MSTRocketDesignTeam/SRAD-Flight-Computer/hardware/pinMapping.pdf

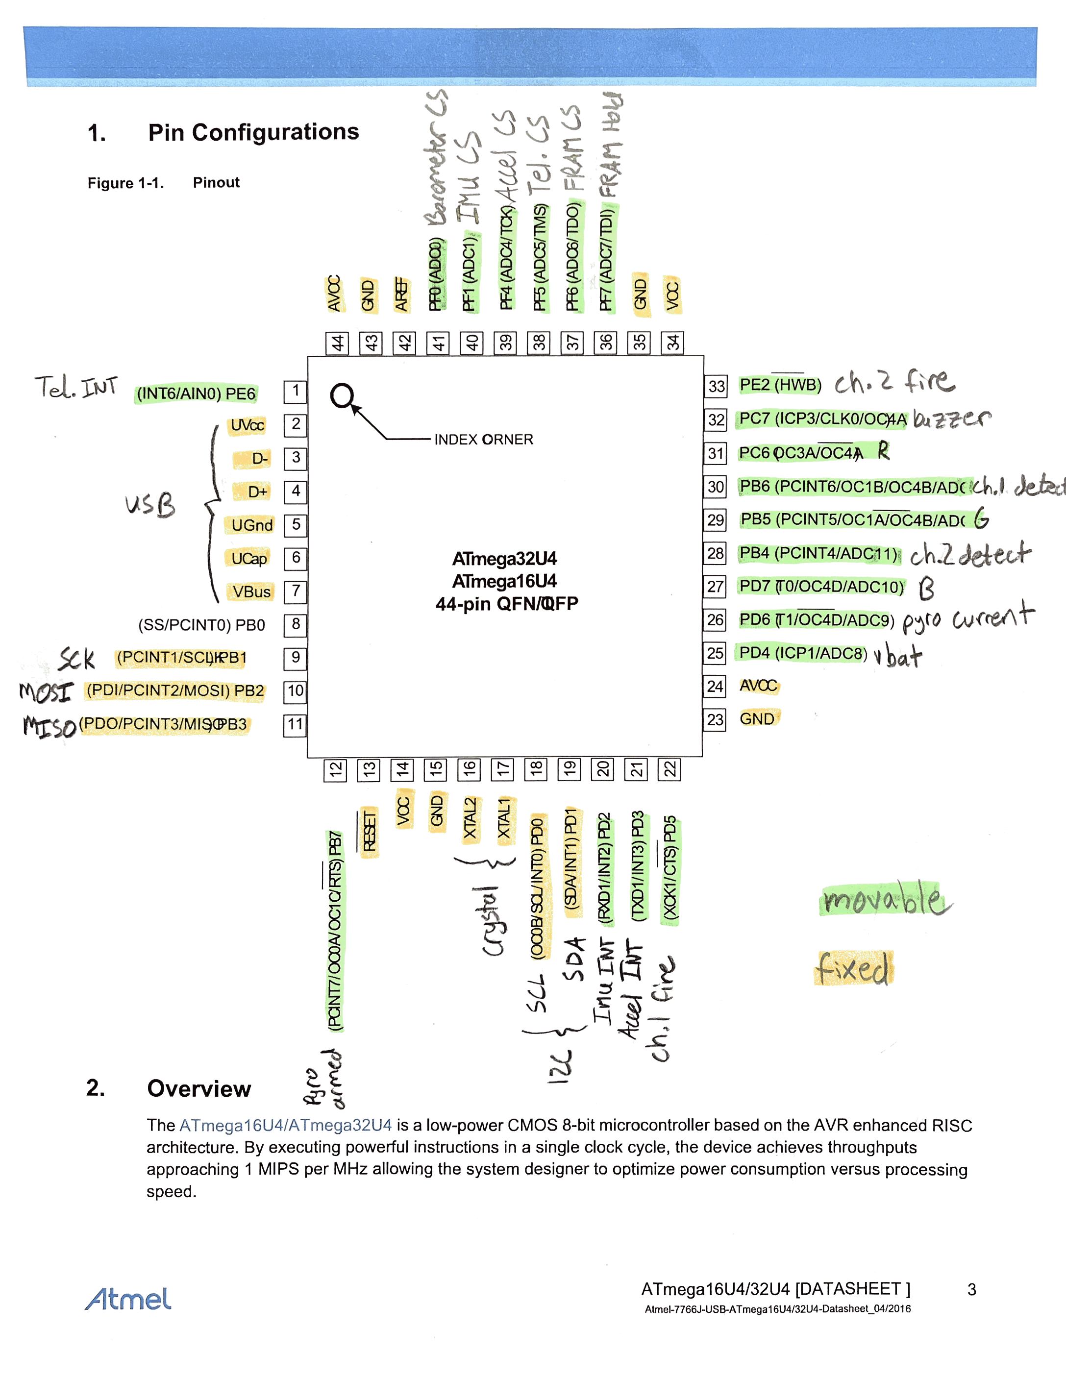
[picture p2: page 1]
