MSTRocketDesignTeam/SRAD-Flight-Computer/firmware/fram-testing/platformio-arduino-framRead/basicV2CodeOverview.png

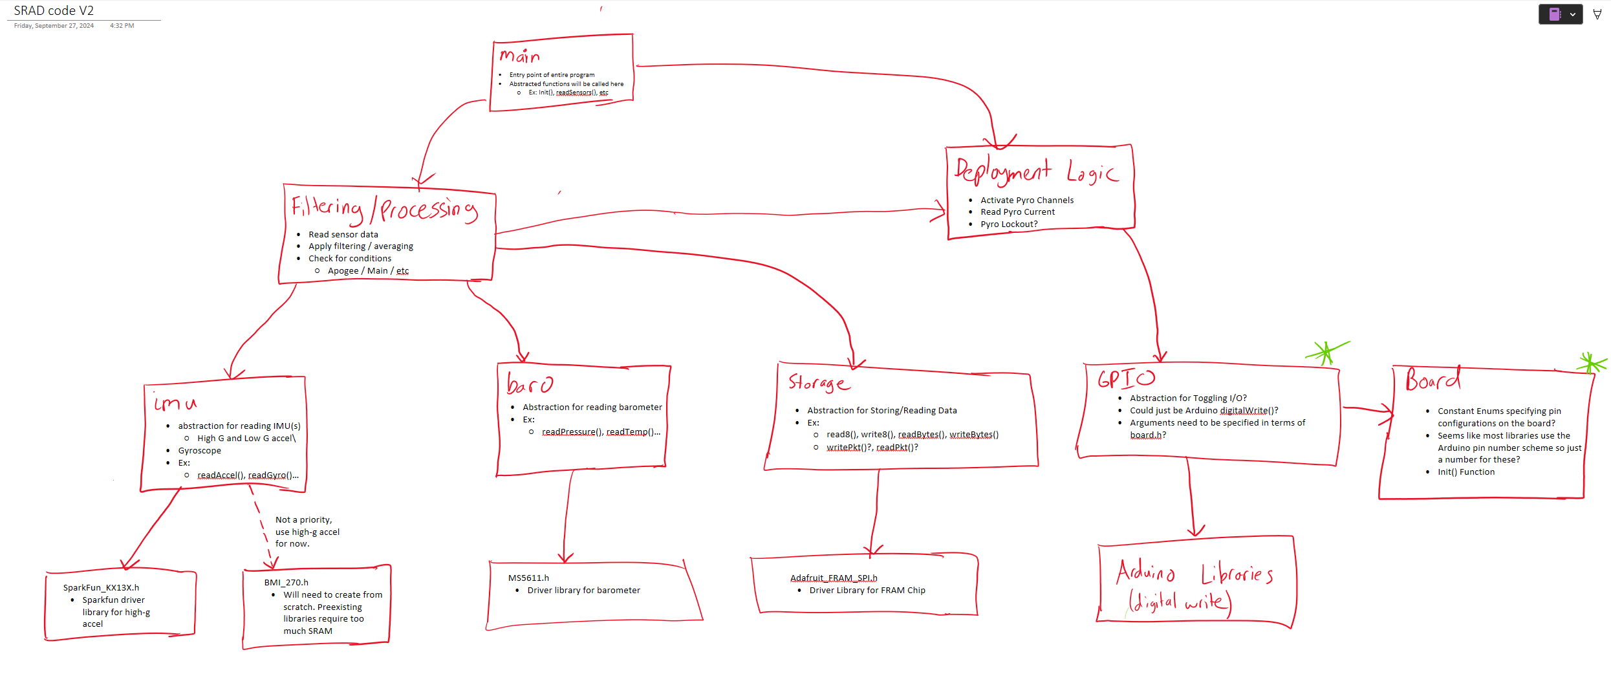
firmware/fram-testing/platformio-arduino-framRead/basicV2CodeOverview.png
