MSTRocketDesignTeam/SRAD-Flight-Computer/hardware/kicad/assets/fram_WP.png

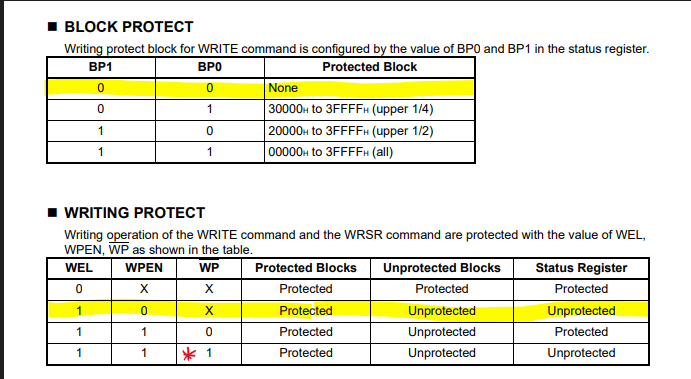
hardware/kicad/assets/fram_WP.png
