MSTRocketDesignTeam/SRAD-Flight-Computer/hardware/kicad/shipping.png

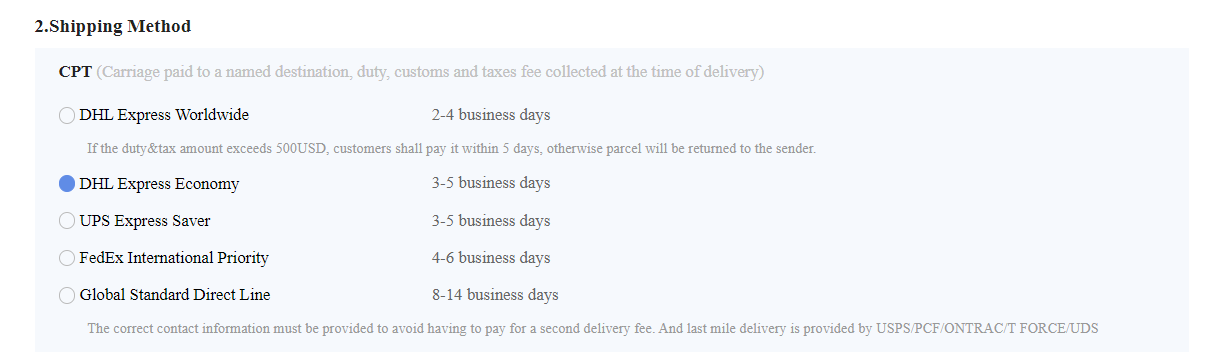
hardware/kicad/shipping.png
