MSTRocketDesignTeam/SRAD-Flight-Computer/hardware/kicad/footprints/BMI270/BMI270.step

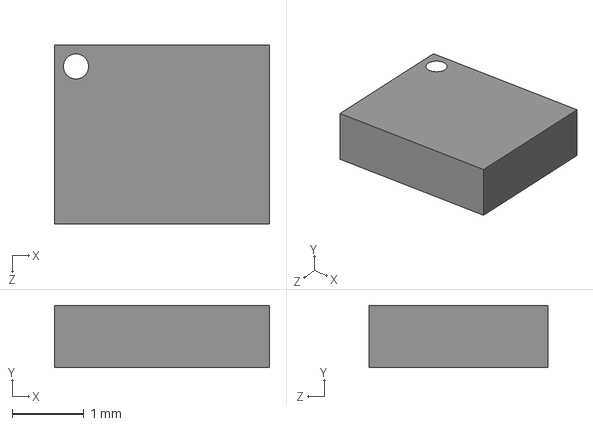
[picture p6: CAD file, 2023-09-16]
hardware/kicad/footprints/BMI270/BMI270.step
3.00 x 0.87 x 2.50 mm
