MSTRocketDesignTeam/SRAD-Flight-Computer/hardware/kicad/footprints/CONSMA020.062/CONSMA020.062-G.step

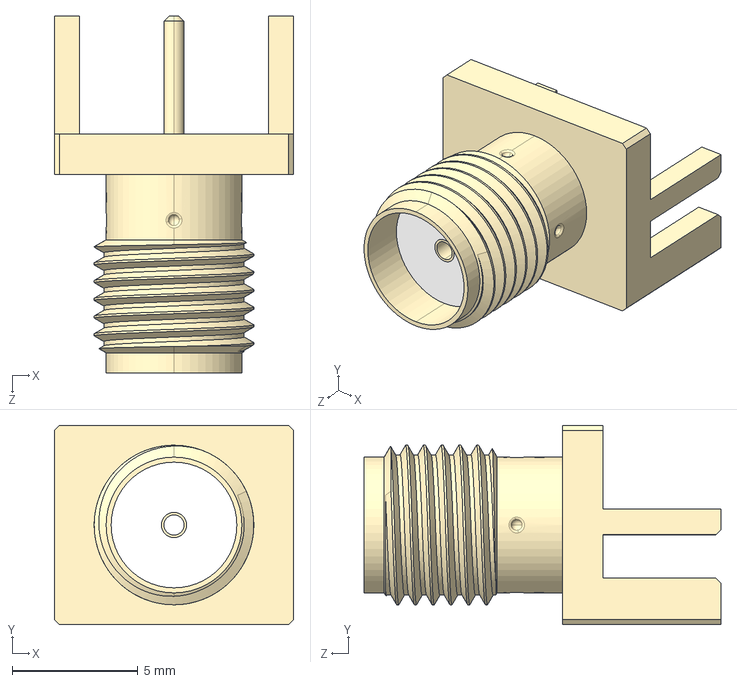
[picture p7: CAD file, 2022-08-10]
hardware/kicad/footprints/CONSMA020.062/CONSMA020.062-G.step
9.52 x 7.92 x 14.2 mm
