MSTRocketDesignTeam/SRAD-Flight-Computer/hardware/kicad/footprints/282834-2/282834-2.step

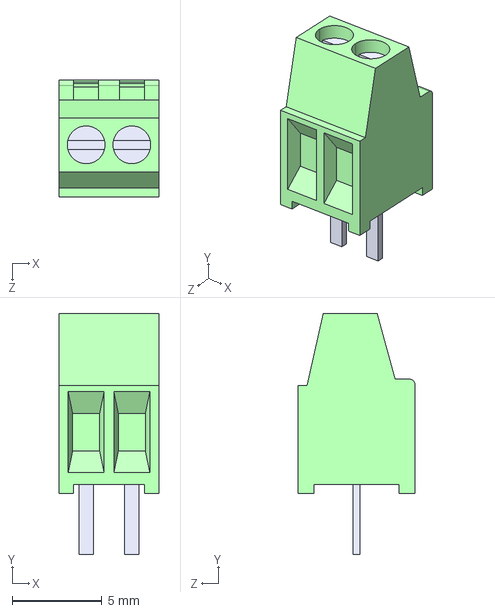
[picture p8: CAD file, 2023-10-20]
hardware/kicad/footprints/282834-2/282834-2.step
5.54 x 13.4 x 6.50 mm
