MSTRocketDesignTeam/SRAD-Flight-Computer/hardware/kicad/footprints/282834-4/282834-4.STEP

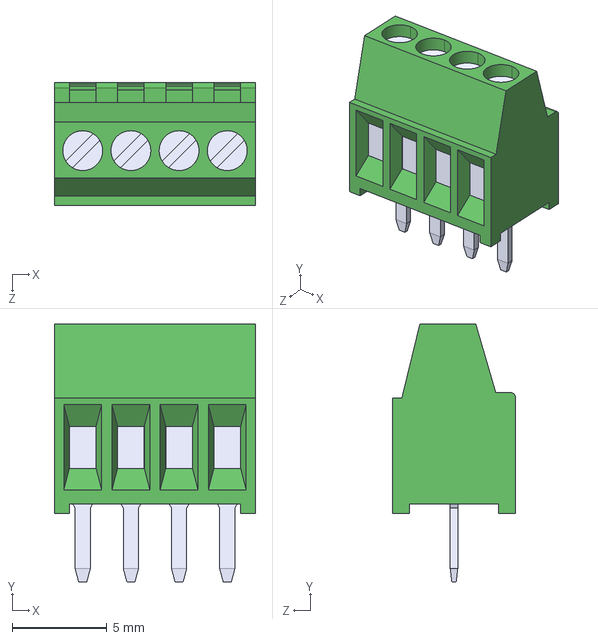
[picture p9: CAD file, 2023-09-16]
hardware/kicad/footprints/282834-4/282834-4.STEP
10.6 x 13.6 x 6.50 mm
