MSTRocketDesignTeam/SRAD-Flight-Computer/firmware/fram-testing/platformio-arduino-framRead/ReadME.md

# Bootloader
Caterina.zip contains a modified bootloader that disables the USB VREG and disables pin output.
