MSTRocketDesignTeam/SRAD-Flight-Computer/firmware/altimeter-data-dump/actualExportTestCSVPressure.csv

Time (s) | Pressure (MilliBar)
0.026 | 959.91
0.052 | 959.92
0.077 | 959.91
0.104 | 959.94
0.129 | 959.89
0.155 | 959.93
0.181 | 959.86
0.206 | 959.9
0.233 | 959.87
0.259 | 959.85
0.284 | 958.48
0.31 | 959.91
0.335 | 959.5099
0.362 | 959.38
0.388 | 959.2
0.439 | 958.93
0.464 | 958.56
0.49 | 957.48
0.517 | 956.78
0.542 | 955.94
0.568 | 954.79
0.593 | 953.77
0.62 | 952.53
0.646 | 951.37
0.671 | 950.58
0.697 | 950.03
0.722 | 949.55
0.749 | 948.87
0.775 | 947.62
0.8 | 946.27
0.851 | 944.89
0.877 | 943.6
0.904 | 940.54
0.929 | 938.88
0.955 | 937.0099
0.98 | 935.31
1.006 | 933.48
1.033 | 931.63
1.058 | 930.03
1.084 | 929.16
1.109 | 931.74
1.135 | 932.31
1.162 | 932.12
1.187 | 931.75
1.213 | 931.3
1.264 | 930.92
1.29 | 930.42
1.316 | 929.41
1.342 | 928.83
1.368 | 928.23
1.393 | 927.66
1.419 | 927.04
1.445 | 926.45
1.471 | 925.97
1.497 | 925.48
1.522 | 924.92
1.549 | 924.41
1.574 | 923.82
1.6 | 923.36
1.626 | 922.82
1.677 | 922.31
1.703 | 921.77
1.729 | 920.75
1.755 | 920.36
1.78 | 919.81
1.806 | 919.24
1.832 | 918.77
1.858 | 918.38
1.884 | 917.8
1.909 | 917.33
1.935 | 916.83
1.961 | 916.37
1.987 | 915.76
2.013 | 915.33
2.038 | 914.83
2.089 | 914.37
2.116 | 913.94
2.142 | 912.91
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
