MSTRocketDesignTeam/SRAD-Flight-Computer/firmware/altimeter-data-dump/actualExportTestCSVAccel.csv

Time (s) | AccelX (g) | AccelY (g) | AccelZ (g)
0.0000 | 63.9980 | 63.9980 | 63.9980
0.0260 | 127.9277 | 126.9863 | 127.8770
0.0520 | 127.9316 | 126.9883 | 127.8535
0.0780 | 127.9414 | 127.0137 | 127.8711
0.1040 | 127.9336 | 126.9883 | 127.9062
0.1290 | 127.9238 | 126.9902 | 127.8965
0.1550 | 127.9277 | 127.0488 | 127.8535
0.1810 | 127.9258 | 127.0332 | 127.8496
0.2070 | 127.9258 | 127.0332 | 127.8809
0.2330 | 127.9199 | 127.0508 | 127.8730
0.2590 | 127.9082 | 126.9941 | 127.8750
0.2840 | 127.5586 | 116.9941 | 124.7461
0.3100 | 125.8672 | 105.3730 | 126.4688
0.3360 | 127.3770 | 101.2500 | 5.6699
0.3620 | 0.2676 | 99.2109 | 3.6289
0.3880 | 0.4473 | 98.0254 | 1.7109
0.4130 | 63.9980 | 63.9980 | 63.9980
0.4390 | 2.3477 | 97.0977 | 1.8496
0.4640 | 1.8340 | 95.4824 | 0.8945
0.4910 | 0.1250 | 94.7246 | 0.0879
0.5170 | 0.2500 | 94.0430 | 0.6465
0.5420 | 0.2656 | 93.7207 | 1.0059
0.5680 | 0.1855 | 93.4102 | 1.2227
0.5940 | 127.9863 | 93.0000 | 1.2148
0.6200 | 0.4219 | 92.8164 | 1.4141
0.6460 | 0.1699 | 92.9258 | 1.3926
0.6710 | 127.9785 | 92.7051 | 1.3379
0.6970 | 127.7109 | 92.5078 | 1.0117
0.7230 | 0.1289 | 92.5195 | 0.9375
0.7490 | 0.6133 | 92.6133 | 1.0137
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
