MSTRocketDesignTeam/SRAD-Flight-Computer/(commit log)

2022-08-08 work on preliminary dev board schematic
    [dev-board.kicad_pcb, dev-board.kicad_sch, esp32-s3fn8.kicad_sch, icm-20608g.kicad_sch, kx134-1211.kicad_sch, ms5611.kicad_sch]
2022-08-10 Update Files
    [dev-board.kicad_sch, icm-20608g.kicad_sch, kx134-1211.kicad_sch, mmc5983ma.kicad_sch, ms5611.kicad_sch, zoe-m8q.kicad_sch]
2022-08-10 More RF Stuff Routed
    [dev-board.kicad_sch, zoe-m8q.kicad_sch]
2022-08-12 more gps work
    [dev-board.kicad_sch]
2022-08-13 finished GPSschematic
    [dev-board.kicad_sch, sx1262.kicad_sch, zoe-m8q.kicad_sch]
2022-08-14 file sync
    [dev-board.kicad_sch, mmc5983ma.kicad_sch, zoe-m8q.kicad_sch]
2022-08-17 rf is hard
    [dev-board.kicad_sch, icm-20608g.kicad_sch, kx134-1211.kicad_sch, mmc5983ma.kicad_sch, ms5611.kicad_sch, sx1262.kicad_sch, zoe-m8q.kicad_sch]
2022-09-01 some rf work
    [SX1262MB1PAS_915MHz_e449v01a_BOM.xlsx, dev-board.kicad_sch, sx1262.kicad_sch]
2023-09-15 purging old files
    [SX1262MB1PAS_915MHz_e449v01a_BOM.xlsx, dev-board.kicad_pcb, dev-board.kicad_sch, esp32-s3fn8.kicad_sch, icm-20608g.kicad_sch, kx134-1211.kicad_sch, mmc5983ma.kicad_sch, ms5611.kicad_sch]
2023-09-16 created kicad project and added datasheets
    [FC.kicad_pcb, FC.kicad_sch, SX1262MB1PAS_915MHz_e449v01a_BOM.xlsx]
2023-09-16 added footprints
    [282834-4.STEP, BMI270.step, CONSMA020.062-G.step]
2023-09-16 added pyro channel sheet
    [FC.kicad_sch, pyro_channel.kicad_sch]
2023-09-16 created schematic files
    [FC.kicad_sch, bmi-270.kicad_sch, bmm-350.kicad_sch, kx134-1211.kicad_sch, m10s.kicad_sch, mb85rs2mtapnf.kicad_sch, ms5611.kicad_sch, ra-01sh.kicad_sch]
2023-09-16 created microcontroller schematic
    [FC.kicad_sch, atmega32u4.kicad_sch, bmi-270.kicad_sch, bmm-350.kicad_sch, kx134-1211.kicad_sch, m10s.kicad_sch, mb85rs2mtapnf.kicad_sch, ms5611.kicad_sch]
2023-09-16 assigned schematics
    [FC.kicad_sch]
2023-09-16 added ms5611 t o schematic
    [ms5611.kicad_sch]
2023-09-16 FRAM schematic
    [mb85rs2mtapnf.kicad_sch]
2023-09-18 fixed sma connector, added to .gitignore
2023-09-20 progress on microcontroller USB
    [atmega32u4.kicad_sch]
2023-09-20 added tc2030 header
    [atmega32u4.kicad_sch]
2023-09-21 finalized tc2030 symbol
    [atmega32u4.kicad_sch]
2023-09-22 syncing uC board before fixing files
    [atmega32u4.kicad_sch]
2023-09-22 uC signal routing
    [atmega32u4.kicad_sch, pyro_channel.kicad_sch]
2023-09-22 uC pinMap progress
    [atmega32u4.kicad_sch]
2023-09-22 updated ms5611 schematic
    [ms5611.kicad_sch]
2023-09-22 Storage Updated
    Updated hierarchal sheet and added pins in and out of sheet
    [mb85rs2mtapnf.kicad_sch]
2023-09-22 Storage Updated
    Didn't save. Added pins to hierarchal sheets. In/Out
    [FC.kicad_sch, atmega32u4.kicad_sch, mb85rs2mtapnf.kicad_sch, ms5611.kicad_sch, ra-01sh.kicad_sch]
2023-09-22 Added Resistor
    [bmi-270.kicad_sch]
2023-09-22 Removed debug from pyro schematic
    [pyro_channel.kicad_sch]
2023-09-22 updated barometer schematic
    [ms5611.kicad_sch, ra-01sh.kicad_sch]
2023-09-22 edited barometer
    [ms5611.kicad_sch]
2023-09-22 fixing weird bugs
    [FC.kicad_sch, pyro_channel.kicad_sch, ra-01sh.kicad_sch]
2023-09-22 fixed weird fork on high g accel sheet
    [kx134-1211.kicad_sch]
2023-09-22 added spi and cs pins
    [atmega32u4.kicad_sch]
2023-09-23 progress on uC
    [atmega32u4.kicad_sch]
2023-09-27 added buzzer
    [atmega32u4.kicad_sch]
2023-09-28 added comments to storage and telemetry radio
    [mb85rs2mtapnf.kicad_sch, ra-01sh.kicad_sch]
2023-09-29 massive comment upload
    [atmega32u4.kicad_sch, bmi-270.kicad_sch, bmm-350.kicad_sch, kx134-1211.kicad_sch, m10s.kicad_sch, ms5611.kicad_sch]
2023-09-29 finished comments
    [bmi-270.kicad_sch]
2023-09-29 literally moved half the microcontroller pins :(
    [atmega32u4.kicad_sch, ra-01sh.kicad_sch]
2023-09-29 microcontroller done?
    [atmega32u4.kicad_sch]
2023-09-29 added ground station conversion breakout pads
    [atmega32u4.kicad_sch]
2023-09-29 fixed barometer board haha - ben
    [ms5611.kicad_sch]
2023-09-29 Magnometer and LDO integrated
    Constructed the schematic with LDO for voltage regulation for the BMM350 Magnetometer
    [bmm-350.kicad_sch]
2023-09-29 Updated labels
    [pyro_channel.kicad_sch]
2023-09-29 full pin utilization
    [atmega32u4.kicad_sch]
2023-09-29 fixed schematic RA-01SH
    [ra-01sh.kicad_sch]
2023-09-30 Fixed schematic file
    [bmi-270.kicad_sch]
2023-09-30 Max Working Current
    [ra-01sh.kicad_sch]
2023-09-30 added max current
    [atmega32u4.kicad_sch]
2023-09-30 Current Max
    [ms5611.kicad_sch]
2023-09-30 added invert on cs
    [ra-01sh.kicad_sch]
2023-09-30 Added Schematic stuff
    [bmi-270.kicad_sch]
2023-09-30 made gps
    [m10s.kicad_sch]
2023-09-30 Finnished Schematic?
    [bmi-270.kicad_sch]
2023-09-30 fixed schematic
    [kx134-1211.kicad_sch]
2023-10-01 started linking together FC, changed cs directions
    [FC.kicad_sch, bmi-270.kicad_sch, kx134-1211.kicad_sch, ms5611.kicad_sch]
2023-10-01 linking together schematics
    [FC.kicad_sch]
2023-10-01 changed FRAM labels
    [mb85rs2mtapnf.kicad_sch]
2023-10-01 corrected label on magnetometer
    [FC.kicad_sch, bmm-350.kicad_sch]
2023-10-01 corrected I2c line labels
    [FC.kicad_sch, bmm-350.kicad_sch, m10s.kicad_sch]
2023-10-01 added spi and i2c bus
    [FC.kicad_sch]
2023-10-01 Changed LDO to Fixed LM1117-1.8
    Changed LDO cheaper 1.8V LM1117
    [bmm-350.kicad_sch]
2023-10-01 added imu interrupt
    [FC.kicad_sch, bmi-270.kicad_sch]
2023-10-01 checked gps
    [m10s.kicad_sch]
2023-10-02 work on linking everything together
    [FC.kicad_sch, atmega32u4.kicad_sch]
2023-10-02 Fixed BMM350 capacitors
    Fixed BMM350 Capacitors by connecting to ground and connecting to the power pins. Then capacitance values were added to the new LM1117 capacitors
    [bmm-350.kicad_sch]
2023-10-05 added usb connector differential pair labels
    [atmega32u4.kicad_sch]
2023-10-05 added cap to stabilize vbat measurement
    [atmega32u4.kicad_sch]
2023-10-06 added digikey link
    [ms5611.kicad_sch]
2023-10-06 Added Digikey Link to BMI-270
    [bmi-270.kicad_sch]
2023-10-06 added power and checked schematics
    [FC.kicad_sch, atmega32u4.kicad_sch, bmi-270.kicad_sch, bmm-350.kicad_sch, ms5611.kicad_sch, pyro_channel.kicad_sch, ra-01sh.kicad_sch]
2023-10-06 assigned footprints
    [FC.kicad_sch, atmega32u4.kicad_sch, bmi-270.kicad_sch, bmm-350.kicad_sch, kx134-1211.kicad_sch, m10s.kicad_sch, mb85rs2mtapnf.kicad_sch, ms5611.kicad_sch]
2023-10-07 Storage Update
    Made changes following Seth's advice
    [mb85rs2mtapnf.kicad_sch]
2023-10-09 making formatting more consistent
    [atmega32u4.kicad_sch, bmi-270.kicad_sch, bmm-350.kicad_sch, kx134-1211.kicad_sch, m10s.kicad_sch, mb85rs2mtapnf.kicad_sch, ms5611.kicad_sch, pyro_channel.kicad_sch]
2023-10-09 added pyro fuses
    [pyro_channel.kicad_sch]
2023-10-09 added gps integration manual and note on gps schematic
    [m10s.kicad_sch]
2023-10-10 all footprints have been fixed
    [FC.kicad_sch, atmega32u4.kicad_sch, pyro_channel.kicad_sch]
2023-10-10 formatting / exported pdf
    [atmega32u4.kicad_sch, bmm-350.kicad_sch, m10s.kicad_sch, mb85rs2mtapnf.kicad_sch, pyro_channel.kicad_sch]
2023-10-12 changed cap footprint
    [FC.kicad_sch]
2023-10-12 changed fuse value
    [pyro_channel.kicad_sch]
2023-10-12 exported schematic
2023-10-13 created pcb file and imported constraints
    [FC.kicad_pcb]
2023-10-13 GPS Ant. SN
    [m10s.kicad_sch]
2023-10-13 ready for pcb
    [FC.kicad_sch, bmm-350.kicad_sch, pyro_channel.kicad_sch]
2023-10-13 pcb work started
    [FC.kicad_pcb, FC.kicad_sch, bmm-350.kicad_sch, m10s.kicad_sch]
2023-10-15 work on pcb
    [FC.kicad_pcb, FC.kicad_sch, ra-01sh.kicad_sch]
2023-10-20 power routing
    [FC.kicad_pcb, FC.kicad_sch]
2023-10-20 added minimum fire energy thread
    [pyro_channel.kicad_sch]
2023-10-20 altimeter not board
    [NOT Flight Computer.kicad_pcb, NOT Flight Computer.kicad_sch]
2023-10-21 redoing the beautiful traces
    [FC.kicad_pcb, pyro_channel.kicad_sch]
2023-10-21 board outline done
    [FC.kicad_pcb]
2023-10-21 massive routing progress
    [FC.kicad_pcb, FC.kicad_sch, atmega32u4.kicad_sch, pyro_channel.kicad_sch]
2023-10-21 placed zener clamping diodes
    [FC.kicad_pcb]
2023-10-22 dont break plz
    [FC.kicad_pcb, atmega32u4.kicad_sch]
2023-10-27 cs lines
    [FC.kicad_pcb, atmega32u4.kicad_sch]
2023-10-27 finished routing
    [FC.kicad_pcb, atmega32u4.kicad_sch, ms5611.kicad_sch]
2023-10-27 added gnd pour under rf
    [FC.kicad_pcb, atmega32u4.kicad_sch]
2023-10-27 silkscreen suffering
    [FC.kicad_pcb]
2023-10-27 plz don't break
    [FC.kicad_pcb]
2023-10-27 test gerbers and order instructions
    [FC-B_Cu.gbl, FC-B_Mask.gbs, FC-B_Paste.gbp, FC-B_Silkscreen.gbo, FC-Edge_Cuts.gm1, FC-F_Cu.gtl, FC-F_Mask.gts, FC-F_Paste.gtp]
2023-10-28 uploaded finished gerbers
    [FC-B_Cu.gbl, FC-B_Mask.gbs, FC-B_Paste.gbp, FC-B_Silkscreen.gbo, FC-Edge_Cuts.gm1, FC-F_Cu.gtl, FC-F_Mask.gts, FC-F_Paste.gtp]
2023-12-16 trying to setup to ouput avr assembly for debugging
2023-12-17 forgot to sync gerber files
    [FC-B_Cu.gbl, FC-B_Mask.gbs, FC-B_Paste.gbp, FC-B_Silkscreen.gbo, FC-Edge_Cuts.gm1, FC-F_Cu.gtl, FC-F_Mask.gts, FC-F_Paste.gtp]
2023-12-27 slow progress on usb driver
2023-12-29 fixed bug in powersaving and tested USB attachment
    [main.cpp]
2024-01-04 new Error Message HOORAY!
    [main.cpp]
2024-01-12 error found in write()
    [main.cpp]
2024-01-12 killbk bug with tx fixed
    [main.cpp]
2024-01-13 fixed bug in address setting
    [main.cpp]
2024-02-16 adjusted to srad board
2024-02-17 started spi interface class
2024-04-13 created platformio project for arduino framework
2024-05-02 accelerometer is confusing
2024-05-03 added globals for sensors
2024-05-22 sensor data is actually stored in buffer
2024-05-25 sync landed condition fixed
    [main.cpp, storage.cpp, storage.h]
2024-05-25 last minute fix lol
    [storage.cpp]
2024-09-29 created preliminary board.h
2024-10-04 some work on board.cpp
2024-10-05 progress on board.h and gpio.h
2024-10-05 sync current state
2024-10-18 appended .off to old files
    [FC.kicad_sch, atmega32u4.kicad_sch, bmi-270.kicad_sch, bmm-350.kicad_sch, kx134-1211.kicad_sch, m10s.kicad_sch, mb85rs2mtapnf.kicad_sch, ms5611.kicad_sch]
2024-10-18 fixed flight detect logic
    [storage.cpp]
2024-11-15 print all values
2025-01-29 progress on buffer and partial progress on filtering
2025-02-19 finished sampling baro in filtering
2025-03-04 added acceleration sampling to filtering
2025-03-04 work on status print
2025-04-22 pressure data looks pretty good, NOTE: BUG IN FLIGHT STATE LOGIC
    [actualExportTestCSVAccel.csv, actualExportTestCSVPressure.csv]
2025-05-05 created exe, fixed condition, added events
    [accel.cpp, filtering.cpp, save_data_to_file.py, storage.cpp, storage.h]
2025-05-05 finalized code for flight
    [outputAccel.csv, outputPressure.csv]
2026-03-06 unknown changes that I did 2 weeks ago
    [FC.kicad_sch, atmega32u4.kicad_sch, bmi-270.kicad_sch, bmm-350.kicad_sch, kx134-1211.kicad_sch, m10s.kicad_sch, mb85rs2mtapnf.kicad_sch, ms5611.kicad_sch]
2026-03-06 Revert "unknown changes that I did 2 weeks ago"
    This reverts commit b6c5f0726217cd47f7d585879e972461ab822068.
    [FC.kicad_sch, atmega32u4.kicad_sch, bmi-270.kicad_sch, bmm-350.kicad_sch, kx134-1211.kicad_sch, m10s.kicad_sch, mb85rs2mtapnf.kicad_sch, ms5611.kicad_sch]
